AbdulAzeez0001/dronekit-pro/docs/README.md

# Documentation (CC-BY-SA 4.0)

The kit documentation, assembly guide, and the BOM cost analysis live here.

Keep the unverified price claim out of the user-facing docs until the
JLC/LCSC quote confirms it.
