AbdulAzeez0001/dronekit-pro/firmware/README.md

# Firmware

## esp32/  (MIT)
WiFi access point, control panel server (192.168.4.1), WebSocket JSON API,
UART bridge to the STM32, OTA. Develop and test most of this on a spare
ESP32 dev board before the real PCB exists.

## betaflight/  (GPLv3)
Custom Betaflight target for the STM32F405 pinmap, plus the CLI dump from
the kit documentation. This is a Betaflight derivative and is GPLv3.
Test the target logic with Betaflight SITL before flashing hardware.
