AbdulAzeez0001/dronekit-pro/hardware/kicad/baro_flash.kicad_sch

## KiCad design hardware/kicad/baro_flash.kicad_sch (2026-09-07, an earlier design)

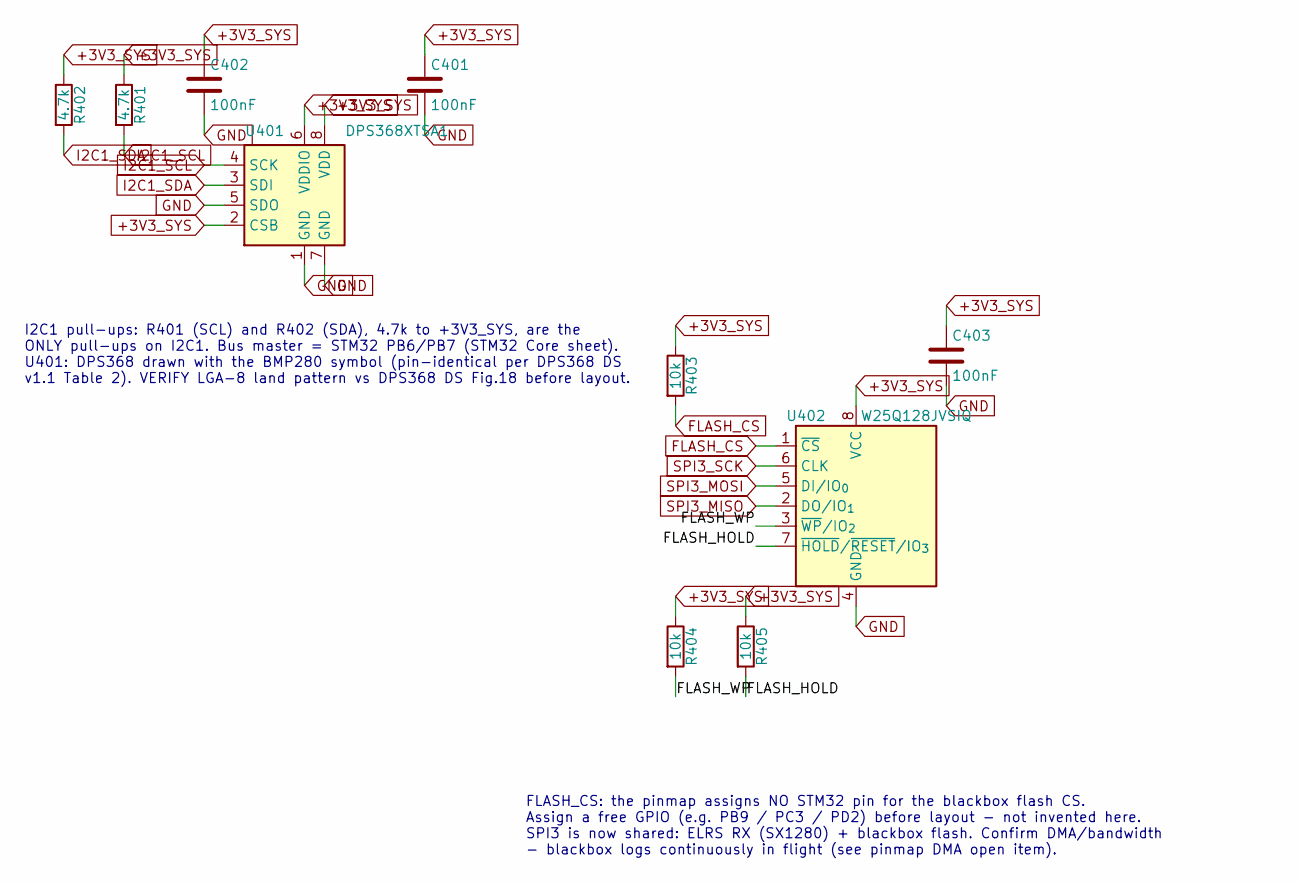
[picture p1: schematic baro_flash.kicad_sch]

Parts:
C401, C402, C403: 100nF; C_0603_1608Metric; MPN CC0603KRX7R9BB104; LCSC C14663
R401, R402: 4.7k; R_0603_1608Metric; MPN 0603WAF4701T5E; LCSC C23162
R403, R404, R405: 10k; R_0603_1608Metric; MPN 0603WAF1002T5E; LCSC C25804
U401: DPS368XTSA1; Bosch_LGA-8_2x2.5mm_P0.65mm_ClockwisePinNumbering; MPN DPS368XTSA1; LCSC C3232508
U402: W25Q128JVSIQ; SOIC-8_5.3x5.3mm_P1.27mm; MPN W25Q128JVSIQ; LCSC C97521

Connections:
+3V3_SYS: C401.1, C402.1, C403.1, R401.1, R402.1, R403.1, R404.1, R405.1, U401.2 (CSB), U401.6 (VDDIO), U401.8 (VDD), U402.8 (VCC)
FLASH_CS: R403.2, U402.1 (~CS)
FLASH_HOLD: R405.2, U402.7 (~HOLD/~RESET/IO_{3})
FLASH_WP: R404.2, U402.3 (~WP/IO_{2})
GND: C401.2, C402.2, C403.2, U401.1 (GND), U401.5 (SDO), U401.7 (GND), U402.4 (GND)
I2C1_SCL: R401.2, U401.4 (SCK)
I2C1_SDA: R402.2, U401.3 (SDI)
SPI3_MISO: U402.2 (DO/IO_{1})
SPI3_MOSI: U402.5 (DI/IO_{0})
SPI3_SCK: U402.6 (CLK)

Notes on the sheet:
I2C1 pull-ups: R401 (SCL) and R402 (SDA), 4.7k to +3V3_SYS, are the ONLY pull-ups on I2C1. Bus master = STM32 PB6/PB7 (STM32 Core sheet). U401: DPS368 drawn with the BMP280 symbol (pin-identical per DPS368 DS v1.1 Table 2). VERIFY LGA-8 land pattern vs DPS368 DS Fig.18 before layout.
FLASH_CS: the pinmap assigns NO STM32 pin for the blackbox flash CS. Assign a free GPIO (e.g. PB9 / PC3 / PD2) before layout - not invented here. SPI3 is now shared: ELRS RX (SX1280) + blackbox flash. Confirm DMA/bandwidth - blackbox logs continuously in flight (see pinmap DMA open item).
