AbdulAzeez0001/dronekit-pro/hardware/kicad/connectors.kicad_sch

## KiCad design hardware/kicad/connectors.kicad_sch (2026-09-07, an earlier design)

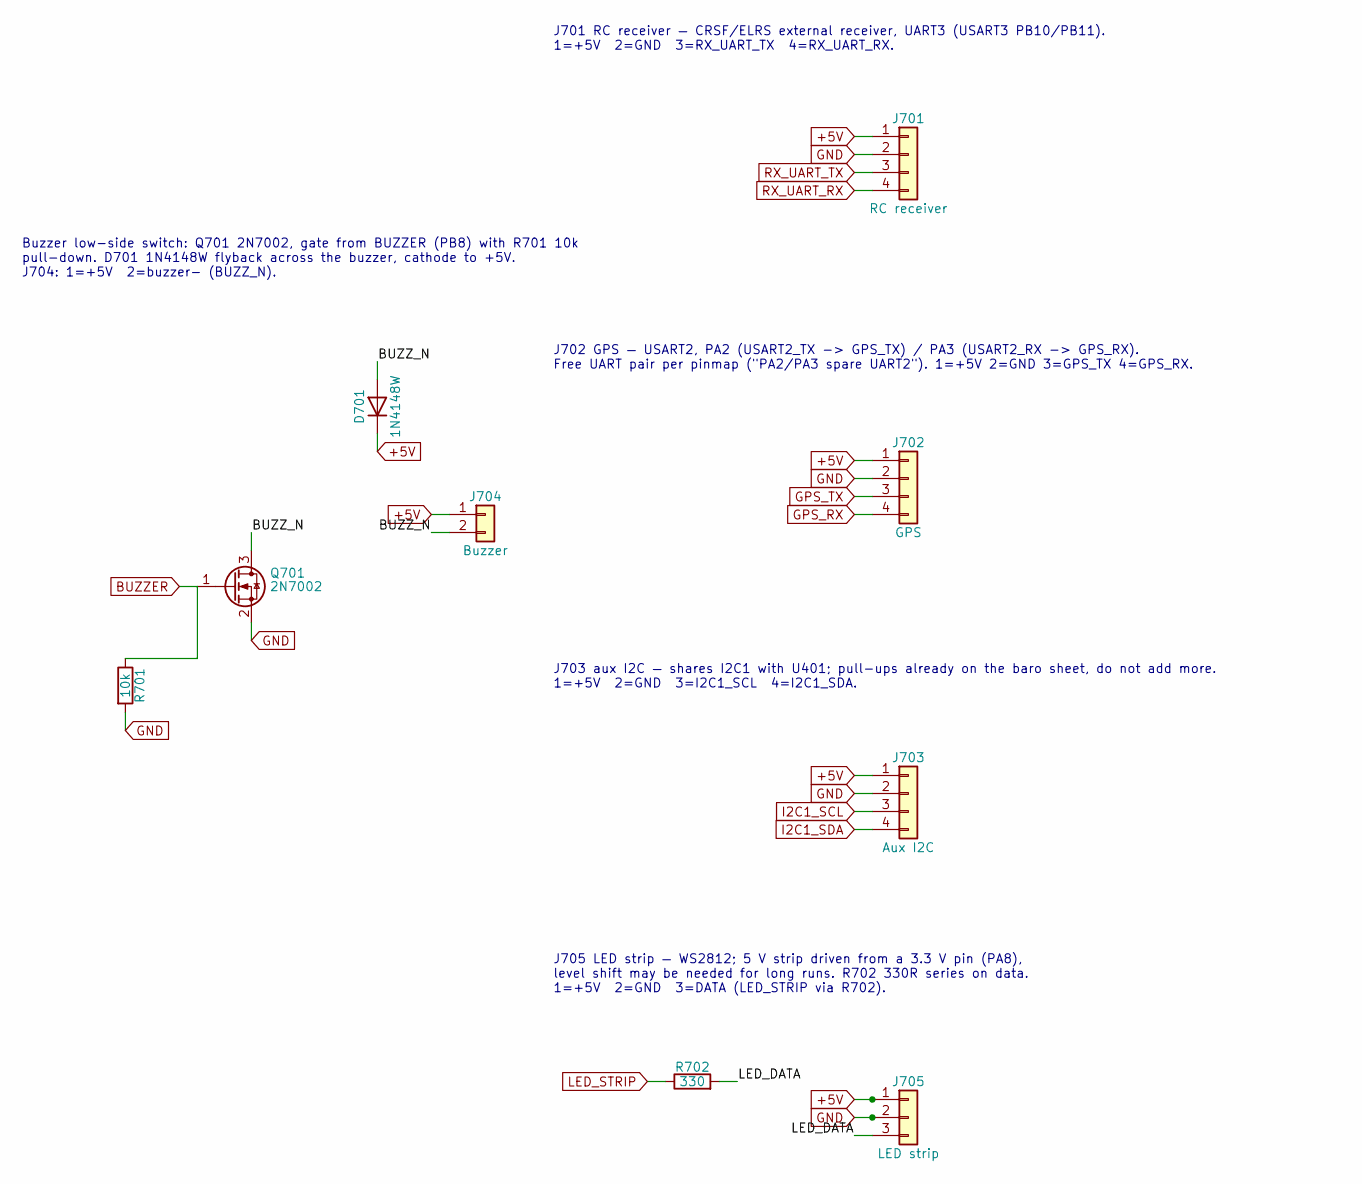
[picture p2: schematic connectors.kicad_sch]

Parts:
D701: 1N4148W; D_SOD-123; MPN 1N4148W; LCSC C81598
J701: RC receiver; JST_SH_SM04B-SRSS-TB_1x04-1MP_P1.00mm_Horizontal; MPN SM04B-SRSS-TB(LF)(SN); LCSC C160404
J702: GPS; JST_SH_SM04B-SRSS-TB_1x04-1MP_P1.00mm_Horizontal; MPN SM04B-SRSS-TB(LF)(SN); LCSC C160404
J703: Aux I2C; JST_SH_SM04B-SRSS-TB_1x04-1MP_P1.00mm_Horizontal; MPN SM04B-SRSS-TB(LF)(SN); LCSC C160404
J704: Buzzer; JST_SH_SM02B-SRSS-TB_1x02-1MP_P1.00mm_Horizontal; MPN SM02B-SRSS-TB(LF)(SN); LCSC C160402
J705: LED strip; JST_SH_SM03B-SRSS-TB_1x03-1MP_P1.00mm_Horizontal; MPN SM03B-SRSS-TB(LF)(SN); LCSC C160403
Q701: 2N7002; SOT-23; MPN 2N7002; LCSC C8545
R701: 10k; R_0603_1608Metric; MPN 0603WAF1002T5E; LCSC C25804
R702: 330; R_0603_1608Metric; MPN 0603WAF3300T5E; LCSC C23138

Connections:
+5V: D701.1 (K), J701.1, J702.1, J703.1, J704.1, J705.1
BUZZER: Q701.1 (G), R701.1
BUZZ_N: D701.2 (A), J704.2, Q701.3 (D)
GND: J701.2, J702.2, J703.2, J705.2, Q701.2 (S), R701.2
GPS_RX: J702.4
GPS_TX: J702.3
I2C1_SCL: J703.3
I2C1_SDA: J703.4
LED_DATA: J705.3, R702.2
LED_STRIP: R702.1
RX_UART_RX: J701.4
RX_UART_TX: J701.3

Notes on the sheet:
J701 RC receiver — CRSF/ELRS external receiver, UART3 (USART3 PB10/PB11). 1=+5V 2=GND 3=RX_UART_TX 4=RX_UART_RX.
J702 GPS — USART2, PA2 (USART2_TX -> GPS_TX) / PA3 (USART2_RX -> GPS_RX). Free UART pair per pinmap ("PA2/PA3 spare UART2"). 1=+5V 2=GND 3=GPS_TX 4=GPS_RX.
J703 aux I2C — shares I2C1 with U401; pull-ups already on the baro sheet, do not add more. 1=+5V 2=GND 3=I2C1_SCL 4=I2C1_SDA.
J705 LED strip — WS2812; 5 V strip driven from a 3.3 V pin (PA8), level shift may be needed for long runs. R702 330R series on data. 1=+5V 2=GND 3=DATA (LED_STRIP via R702).
Buzzer low-side switch: Q701 2N7002, gate from BUZZER (PB8) with R701 10k pull-down. D701 1N4148W flyback across the buzzer, cathode to +5V. J704: 1=+5V 2=buzzer- (BUZZ_N).
