AbdulAzeez0001/dronekit-pro/hardware/kicad/dronekit-pro.kicad_sch

## KiCad design hardware/kicad/dronekit-pro.kicad_sch (2026-09-07, an earlier design)

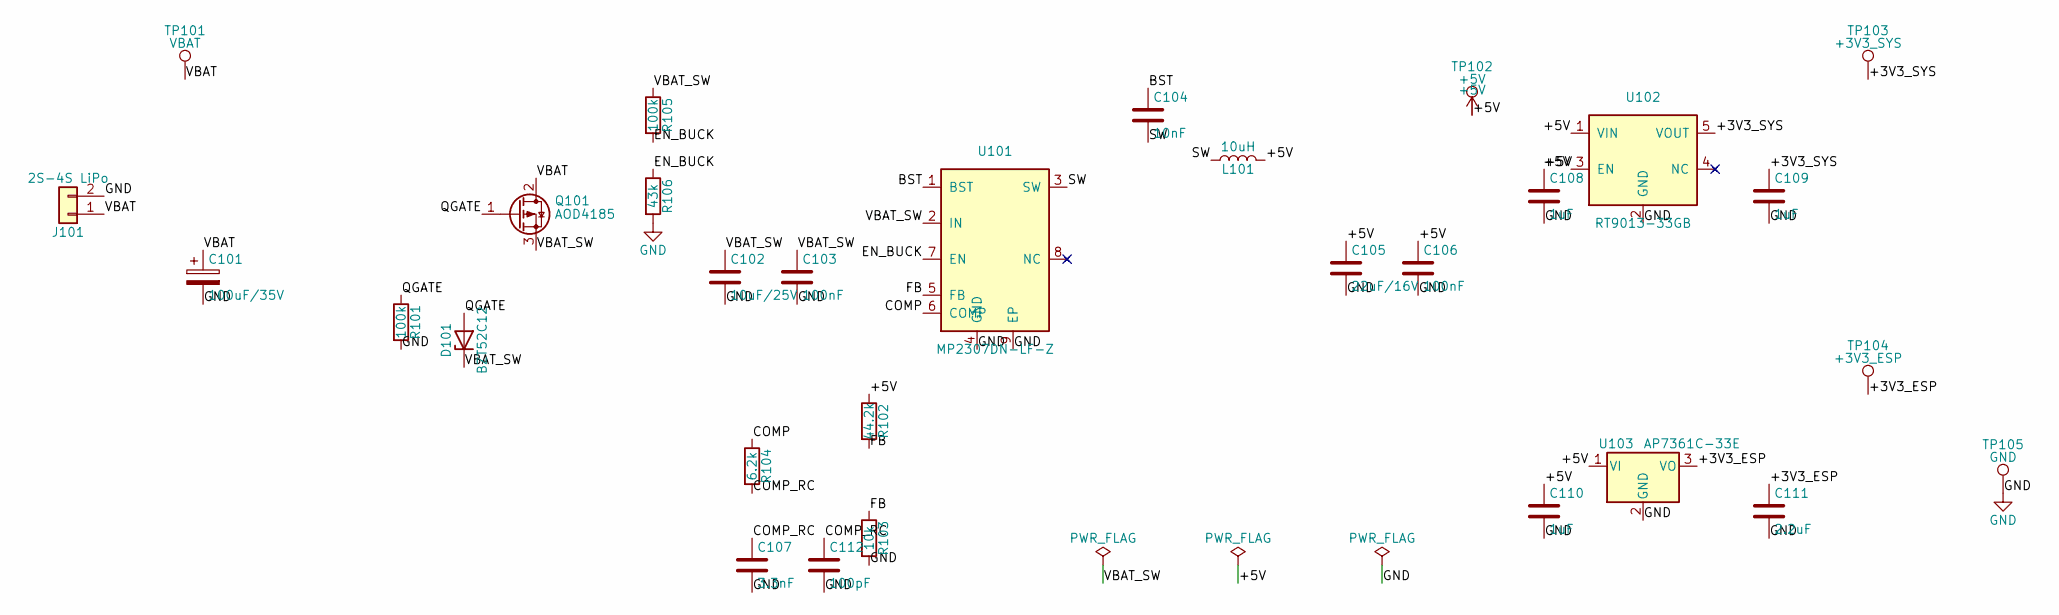
[picture p3: schematic dronekit-pro.kicad_sch]

Parts:
C101: 100uF/35V; CP_Elec_6.3x7.7
C102: 10uF/25V; C_1210_3225Metric
C103, C106: 100nF; C_0603_1608Metric
C104: 10nF; C_0603_1608Metric
C105: 22uF/16V; C_1206_3216Metric
C107: 3.3nF; C_0603_1608Metric
C108, C109, C110: 1uF; C_0603_1608Metric
C111: 2.2uF; C_0603_1608Metric
C112: 100pF; C_0603_1608Metric
D101: BZT52C12; D_SOD-123; LCSC C43491
J101: 2S-4S LiPo; PhoenixContact_MSTBA_2,5_2-G-5,08_1x02_P5.08mm_Horizontal; LCSC C474952
L101: 10uH; L_12x12mm_H8mm; Rating Isat 9A, Irms 5.4A, DCR 21mOhm; MPN SMDRI127-100MT; LCSC C9904
Q101: AOD4185; TO-252-2; LCSC C400894
R101, R105: 100k; R_0603_1608Metric
R102: 44.2k; R_0603_1608Metric
R103: 10k; R_0603_1608Metric
R104: 6.2k; R_0603_1608Metric
R106: 43k; R_0603_1608Metric
TP101: VBAT; TestPoint_Pad_D1.5mm
TP102: +5V; TestPoint_Pad_D1.5mm
TP103: +3V3_SYS; TestPoint_Pad_D1.5mm
TP104: +3V3_ESP; TestPoint_Pad_D1.5mm
TP105: GND; TestPoint_Pad_D1.5mm
U101: MP2307DN-LF-Z; SOIC-8-1EP_3.9x4.9mm_P1.27mm_EP2.29x3mm; LCSC C18921
U102: RT9013-33GB; SOT-23-5; LCSC C47773
U103: AP7361C-33E; SOT-223-3_TabPin2; LCSC C500795

Connections:
+3V3_ESP: C111.1, TP104.1, U103.3 (VO)
+3V3_SYS: C109.1, TP103.1, U102.5 (VOUT)
+5V: C105.1, C106.1, C108.1, C110.1, L101.2, R102.1, TP102.1, U102.1 (VIN), U102.3 (EN), U103.1 (VI)
BST: C104.1, U101.1 (BST)
COMP: R104.1, U101.6 (COMP)
COMP_RC: C107.1, C112.1, R104.2
EN_BUCK: R105.2, R106.1, U101.7 (EN)
FB: R102.2, R103.1, U101.5 (FB)
GND: C101.2, C102.2, C103.2, C105.2, C106.2, C107.2, C108.2, C109.2, C110.2, C111.2, C112.2, J101.2, R101.2, R103.2, R106.2, TP105.1, U101.4 (GND), U101.9 (EP), U102.2 (GND), U103.2 (GND)
QGATE: D101.2 (A), Q101.1 (G), R101.1
SW: C104.2, L101.1, U101.3 (SW)
VBAT: C101.1, J101.1, Q101.2 (D), TP101.1
VBAT_SW: C102.1, C103.1, D101.1 (K), Q101.3 (S), R105.1, U101.2 (IN)
