AbdulAzeez0001/dronekit-pro/hardware/kicad/esp32.kicad_sch

## KiCad design hardware/kicad/esp32.kicad_sch (2026-09-06)

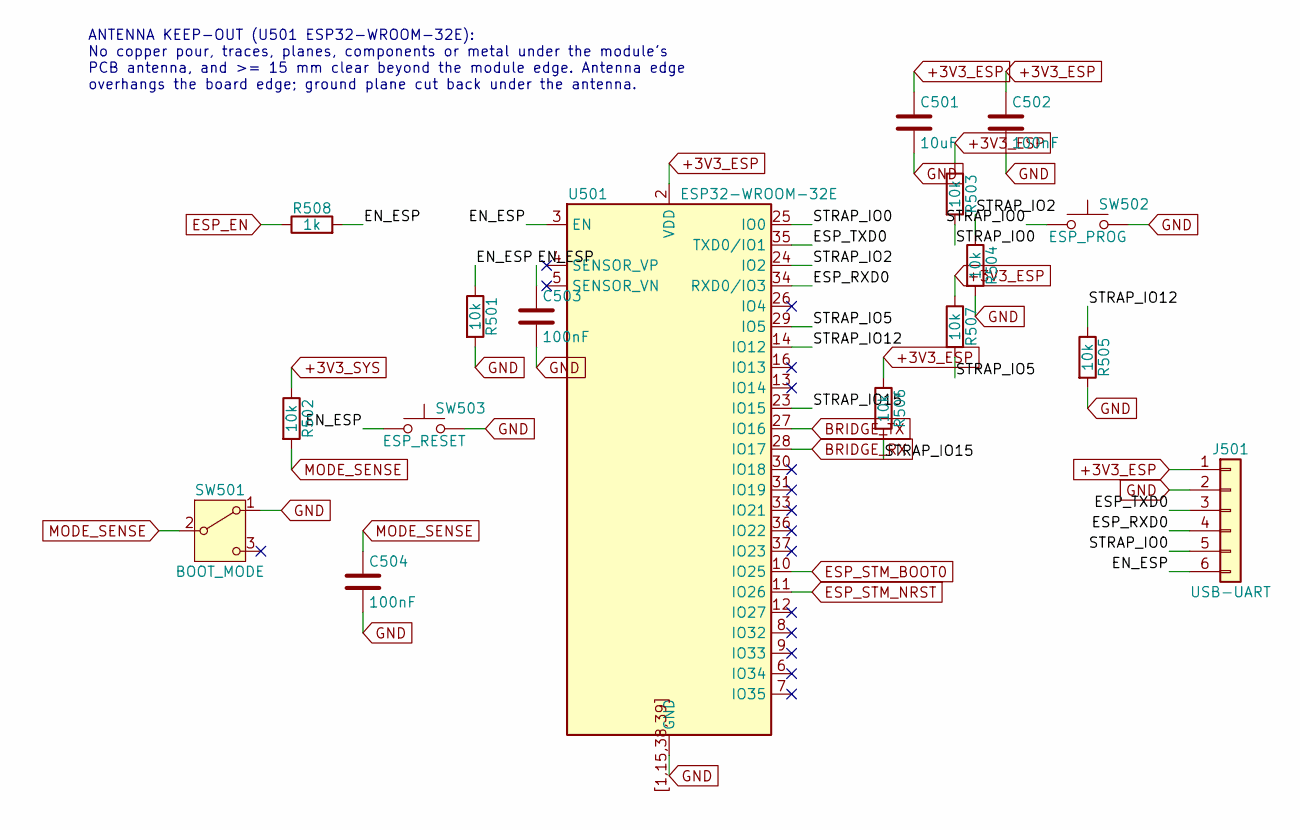
[picture p4: schematic esp32.kicad_sch]

Parts:
C501: 10uF; C_0805_2012Metric; MPN CL21A106KOQNNNE; LCSC C1713
C502, C503, C504: 100nF; C_0402_1005Metric; MPN CL05B104KO5NNNC; LCSC C1525
J501: USB-UART; PinHeader_1x06_P2.54mm_Vertical; MPN 2.54-1*40P Straight Pin (cut to 6); LCSC C2337
R501, R502, R503, R504, R505, R506, R507: 10k; R_0402_1005Metric; MPN 0402WGF1002TCE; LCSC C25744
R508: 1k; R_0402_1005Metric; MPN 0402WGF1001TCE; LCSC C11702
SW501: BOOT_MODE; SW_SPDT_Shouhan_MSK12C02; MPN MSK12C02; LCSC C431540
SW502: ESP_PROG; SW_SPST_TS-1088-xR020; MPN TS-1088-AR02016; LCSC C720477
SW503: ESP_RESET; SW_SPST_TS-1088-xR020; MPN TS-1088-AR02016; LCSC C720477
U501: ESP32-WROOM-32E; MPN ESP32-WROOM-32E-N4; LCSC C701341

Connections:
+3V3_ESP: C501.1, C502.1, J501.1, R503.1, R506.1, R507.1, U501.2 (VDD)
+3V3_SYS: R502.1
BRIDGE_RX: U501.28 (IO17)
BRIDGE_TX: U501.27 (IO16)
EN_ESP: C503.1, J501.6, R501.1, R508.2, SW503.1, U501.3 (EN)
ESP_EN: R508.1
ESP_RXD0: J501.4, U501.34 (RXD0/IO3)
ESP_STM_BOOT0: U501.10 (IO25)
ESP_STM_NRST: U501.11 (IO26)
ESP_TXD0: J501.3, U501.35 (TXD0/IO1)
GND: C501.2, C502.2, C503.2, C504.2, J501.2, R501.2, R504.2, R505.2, SW501.1 (A), SW502.2, SW503.2, U501.[1,15,38,39] (GND)
MODE_SENSE: C504.1, R502.2, SW501.2 (B)
STRAP_IO0: J501.5, R503.2, SW502.1, U501.25 (IO0)
STRAP_IO2: R504.1, U501.24 (IO2)
STRAP_IO5: R507.2, U501.29 (IO5)
STRAP_IO12: R505.1, U501.14 (IO12)
STRAP_IO15: R506.2, U501.23 (IO15)

Notes on the sheet:
ANTENNA KEEP-OUT (U501 ESP32-WROOM-32E): No copper pour, traces, planes, components or metal under the module's PCB antenna, and >= 15 mm clear beyond the module edge. Antenna edge overhangs the board edge; ground plane cut back under the antenna.
