AbdulAzeez0001/dronekit-pro/hardware/kicad/imu.kicad_sch

## KiCad design hardware/kicad/imu.kicad_sch (2026-09-07, an earlier design)

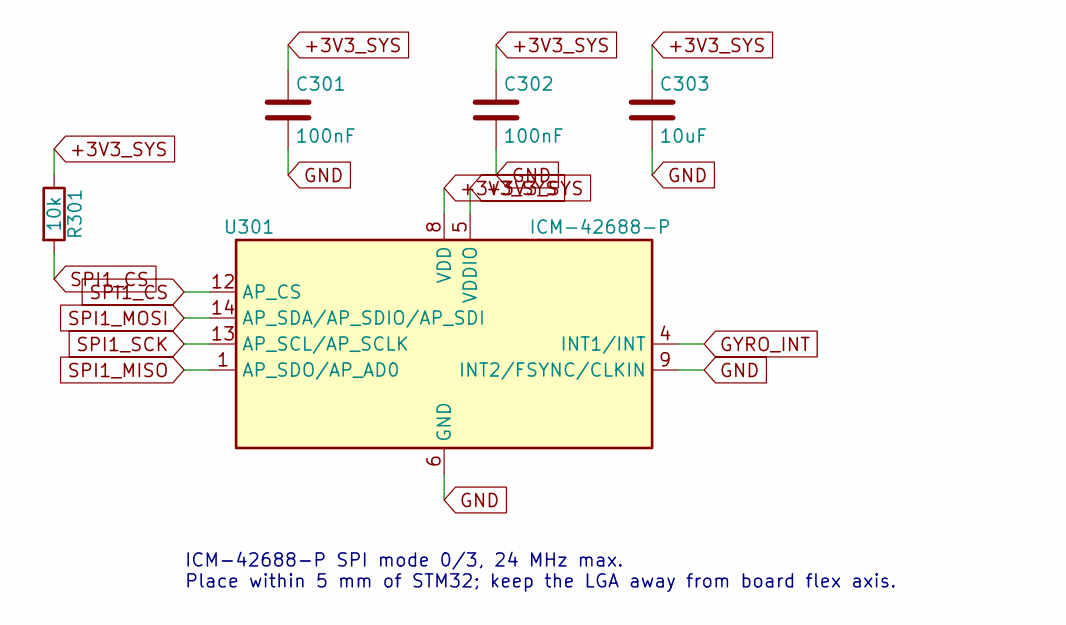
[picture p5: schematic imu.kicad_sch]

Parts:
C301, C302: 100nF; C_0603_1608Metric; MPN CC0603KRX7R9BB104; LCSC C14663
C303: 10uF; C_0603_1608Metric; MPN CL10A106MA8NRNC; LCSC C96446
R301: 10k; R_0603_1608Metric; MPN 0603WAF1002T5E; LCSC C25804
U301: ICM-42688-P; Bosch_LGA-14_3x2.5mm_P0.5mm; MPN ICM-42688-P; LCSC C1850418

Connections:
+3V3_SYS: C301.1, C302.1, C303.1, R301.1, U301.5 (VDDIO), U301.8 (VDD)
GND: C301.2, C302.2, C303.2, U301.6 (GND), U301.7 (GND), U301.9 (INT2/FSYNC/CLKIN)
GYRO_INT: U301.4 (INT1/INT)
SPI1_CS: R301.2, U301.12 (AP_CS)
SPI1_MISO: U301.1 (AP_SDO/AP_AD0)
SPI1_MOSI: U301.14 (AP_SDA/AP_SDIO/AP_SDI)
SPI1_SCK: U301.13 (AP_SCL/AP_SCLK)

Notes on the sheet:
ICM-42688-P SPI mode 0/3, 24 MHz max. Place within 5 mm of STM32; keep the LGA away from board flex axis.
