AbdulAzeez0001/dronekit-pro/hardware/kicad/motors.kicad_sch

## KiCad design hardware/kicad/motors.kicad_sch (2026-09-07)

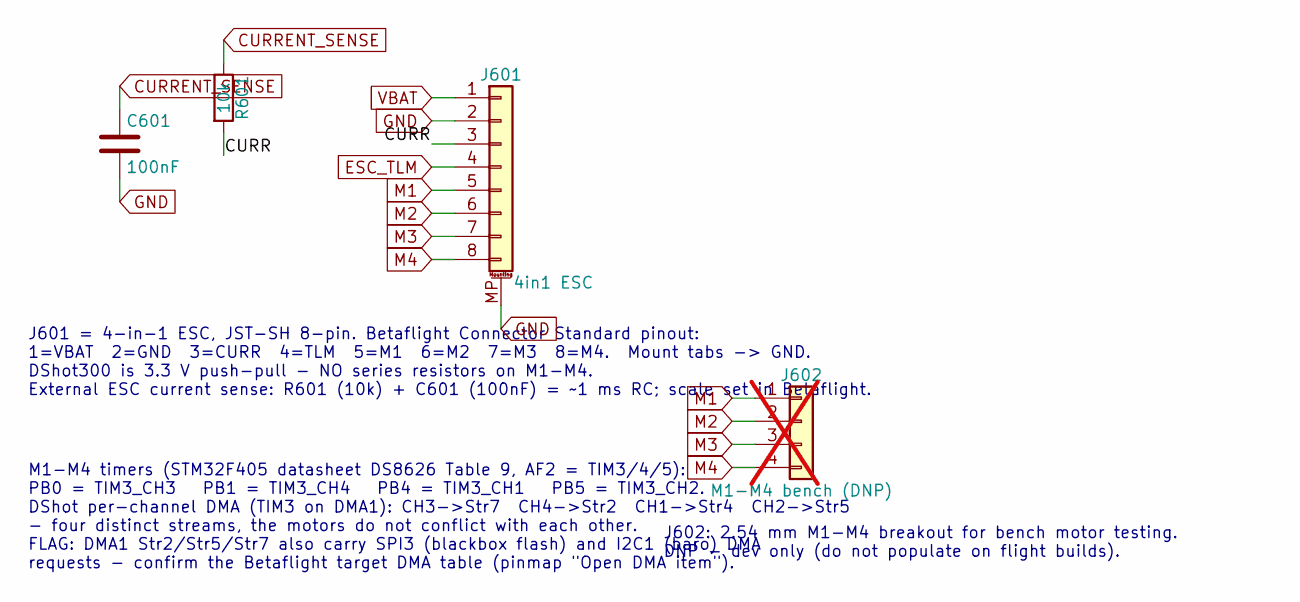
[picture p6: schematic motors.kicad_sch]

Parts:
C601: 100nF; C_0603_1608Metric; MPN CC0603KRX7R9BB104; LCSC C14663
J601: 4in1 ESC; JST_SH_SM08B-SRSS-TB_1x08-1MP_P1.00mm_Horizontal; MPN SM08B-SRSS-TB(LF)(SN); LCSC C160407
J602: M1-M4 bench (DNP); PinHeader_1x04_P2.54mm_Vertical; MPN 2.54-1*40P Straight Pin (cut to 4); LCSC C2337; not fitted
R601: 10k; R_0603_1608Metric; MPN 0603WAF1002T5E; LCSC C25804

Connections:
CURR: J601.3, R601.2
CURRENT_SENSE: C601.1, R601.1
ESC_TLM: J601.4
GND: C601.2, J601.2, J601.MP (MountPin)
M1: J601.5, J602.1
M2: J601.6, J602.2
M3: J601.7, J602.3
M4: J601.8, J602.4
VBAT: J601.1

Notes on the sheet:
J601 = 4-in-1 ESC, JST-SH 8-pin. Betaflight Connector Standard pinout: 1=VBAT 2=GND 3=CURR 4=TLM 5=M1 6=M2 7=M3 8=M4. Mount tabs -> GND. DShot300 is 3.3 V push-pull - NO series resistors on M1-M4. External ESC current sense: R601 (10k) + C601 (100nF) = ~1 ms RC; scale set in Betaflight.
M1-M4 timers (STM32F405 datasheet DS8626 Table 9, AF2 = TIM3/4/5): PB0 = TIM3_CH3 PB1 = TIM3_CH4 PB4 = TIM3_CH1 PB5 = TIM3_CH2. DShot per-channel DMA (TIM3 on DMA1): CH3->Str7 CH4->Str2 CH1->Str4 CH2->Str5 - four distinct streams, the motors do not conflict with each other. FLAG: DMA1 Str2/Str5/Str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
J602: 2.54 mm M1-M4 breakout for bench motor testing. DNP - dev only (do not populate on flight builds).
