AbdulAzeez0001/dronekit-pro/hardware/kicad/stm32_core.kicad_sch

## KiCad design hardware/kicad/stm32_core.kicad_sch (2026-09-07, an earlier design)

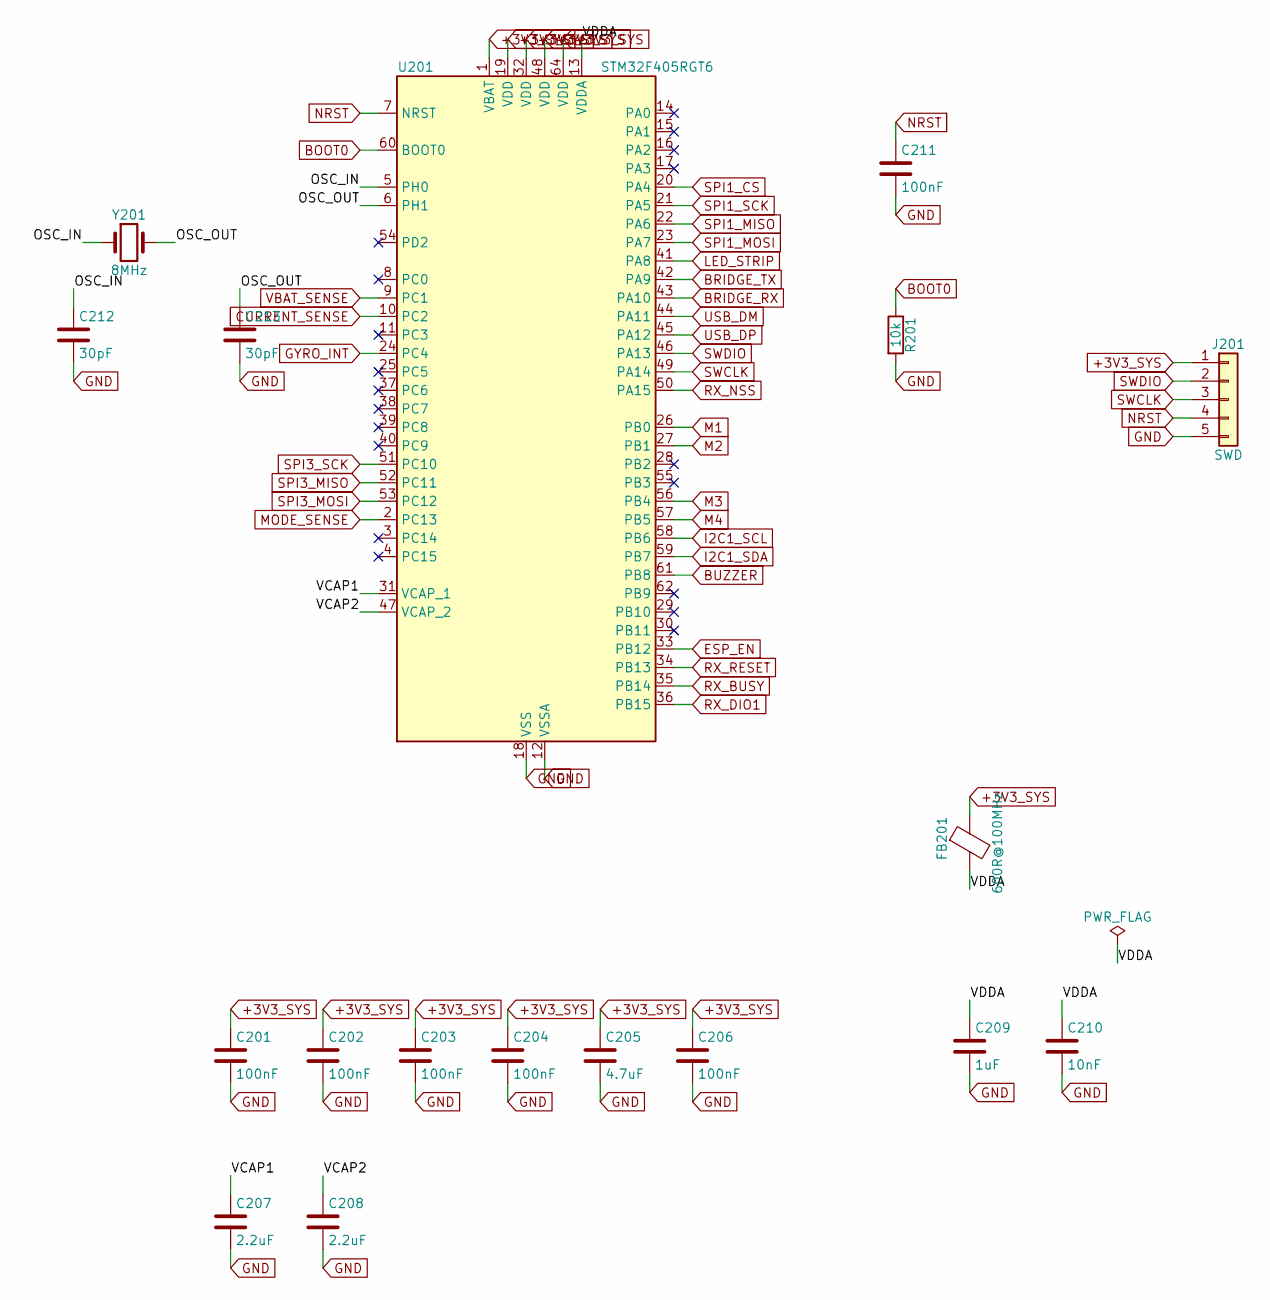
[picture p7: schematic stm32_core.kicad_sch]

Parts:
C201, C202, C203, C204, C206, C211: 100nF; C_0603_1608Metric; MPN CC0603KRX7R9BB104; LCSC C14663
C205: 4.7uF; C_0805_2012Metric; MPN CL21A475KAQNNNE; LCSC C1779
C207, C208: 2.2uF; C_0603_1608Metric; MPN CL10A225KO8NNNC; LCSC C23630
C209: 1uF; C_0603_1608Metric; MPN CL10A105KO8NNNC; LCSC C1592
C210: 10nF; C_0603_1608Metric; MPN CL10B103KB8NNNC; LCSC C1589
C212, C213: 30pF; C_0603_1608Metric; MPN 0603CG300J500NT; LCSC C1658
FB201: 600R@100MHz; L_0805_2012Metric; Rating 600R@100MHz, 300mOhm, 500mA, 0805; MPN GZ2012D601TF; LCSC C1017
J201: SWD; PinHeader_1x05_P2.54mm_Vertical; MPN 2.54-1*40P Straight Pin (cut to 5); LCSC C2337
R201: 10k; R_0603_1608Metric; MPN 0603WAF1002T5E; LCSC C25804
U201: STM32F405RGT6; LQFP-64_10x10mm_P0.5mm; MPN STM32F405RGT6; LCSC C15742
Y201: 8MHz; Crystal_SMD_5032-2Pin_5.0x3.2mm; Tolerance 10ppm; MPN X50328MSB2GI; LCSC C115962

Connections:
+3V3_SYS: C201.1, C202.1, C203.1, C204.1, C205.1, C206.1, FB201.1, J201.1, U201.1 (VBAT), U201.19 (VDD), U201.32 (VDD), U201.48 (VDD), U201.64 (VDD)
BOOT0: R201.1, U201.60 (BOOT0)
BRIDGE_RX: U201.43 (PA10)
BRIDGE_TX: U201.42 (PA9)
BUZZER: U201.61 (PB8)
CURRENT_SENSE: U201.10 (PC2)
ESP_EN: U201.33 (PB12)
GND: C201.2, C202.2, C203.2, C204.2, C205.2, C206.2, C207.2, C208.2, C209.2, C210.2, C211.2, C212.2, C213.2, J201.5, R201.2, U201.12 (VSSA), U201.18 (VSS), U201.63 (VSS)
GYRO_INT: U201.24 (PC4)
I2C1_SCL: U201.58 (PB6)
I2C1_SDA: U201.59 (PB7)
LED_STRIP: U201.41 (PA8)
M1: U201.26 (PB0)
M2: U201.27 (PB1)
M3: U201.56 (PB4)
M4: U201.57 (PB5)
MODE_SENSE: U201.2 (PC13)
NRST: C211.1, J201.4, U201.7 (NRST)
OSC_IN: C212.1, U201.5 (PH0), Y201.1
OSC_OUT: C213.1, U201.6 (PH1), Y201.2
RX_BUSY: U201.35 (PB14)
RX_DIO1: U201.36 (PB15)
RX_NSS: U201.50 (PA15)
RX_RESET: U201.34 (PB13)
SPI1_CS: U201.20 (PA4)
SPI1_MISO: U201.22 (PA6)
SPI1_MOSI: U201.23 (PA7)
SPI1_SCK: U201.21 (PA5)
SPI3_MISO: U201.52 (PC11)
SPI3_MOSI: U201.53 (PC12)
SPI3_SCK: U201.51 (PC10)
SWCLK: J201.3, U201.49 (PA14)
SWDIO: J201.2, U201.46 (PA13)
USB_DM: U201.44 (PA11)
USB_DP: U201.45 (PA12)
VBAT_SENSE: U201.9 (PC1)
VCAP1: C207.1, U201.31 (VCAP_1)
VCAP2: C208.1, U201.47 (VCAP_2)
VDDA: C209.1, C210.1, FB201.2, U201.13 (VDDA)
