AbdulAzeez0001/dronekit-pro/hardware/kicad/usb_power.kicad_sch

## KiCad design hardware/kicad/usb_power.kicad_sch (2026-09-07, an earlier design)

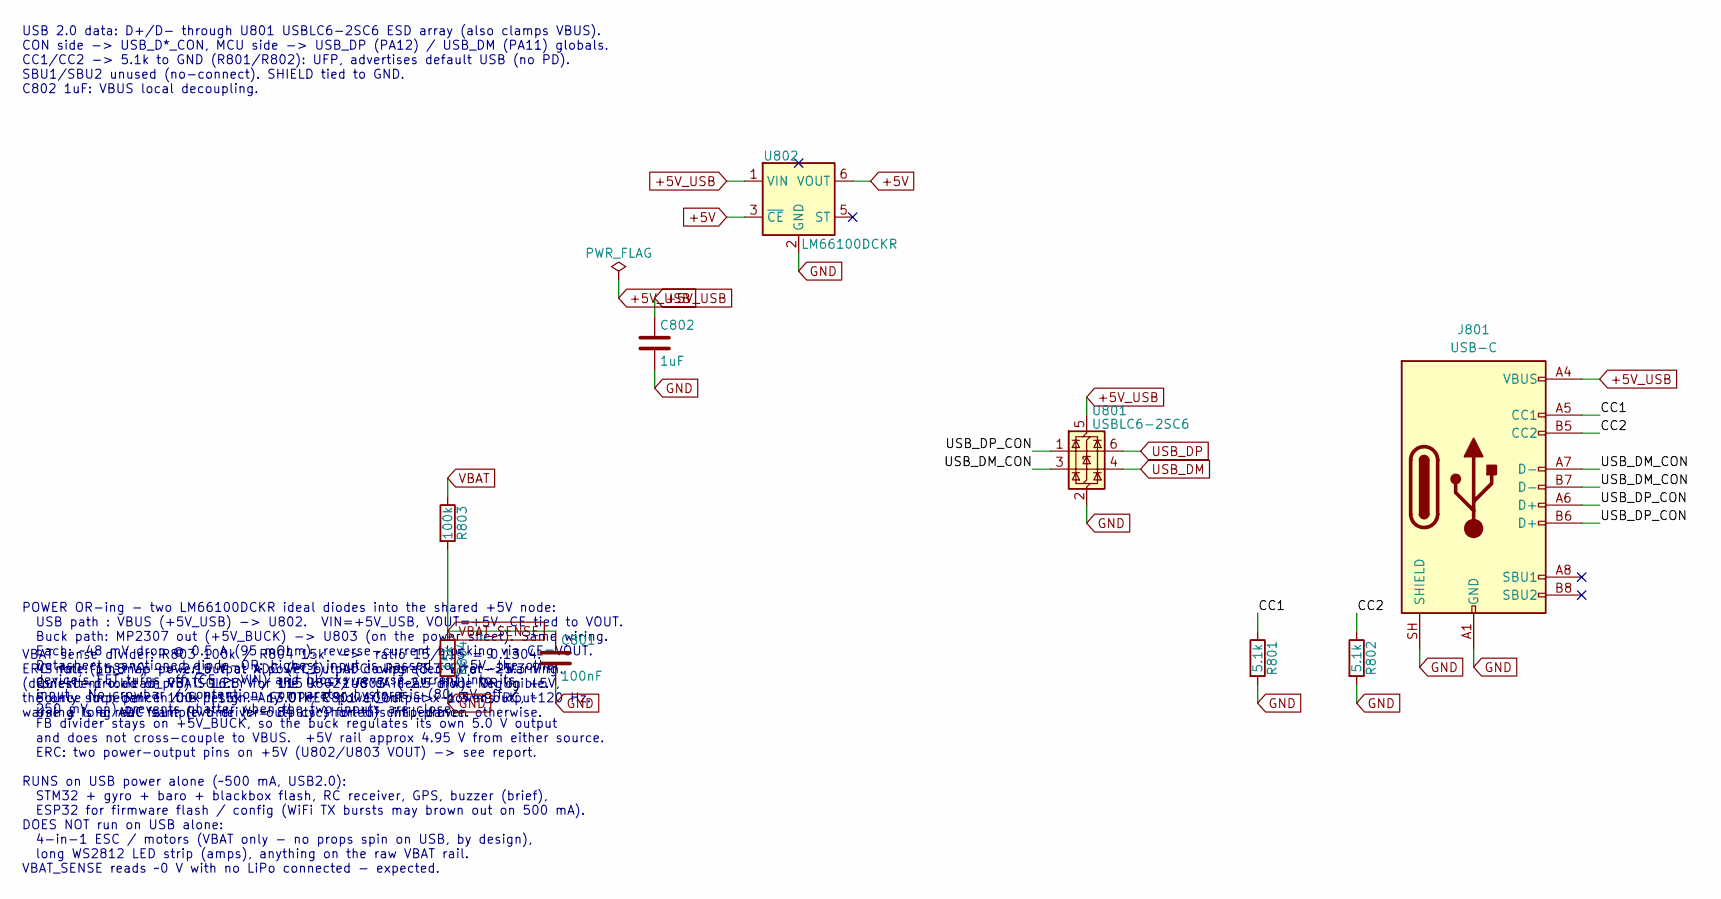
[picture p8: schematic usb_power.kicad_sch]

Parts:
C801: 100nF; C_0603_1608Metric; MPN CC0603KRX7R9BB104; LCSC C14663
C802: 1uF; C_0603_1608Metric; MPN CL10A105KB8NNNC; LCSC C15849
J801: USB-C; USB_C_Receptacle_HRO_TYPE-C-31-M-12; MPN TYPE-C-31-M-12; LCSC C165948
R801, R802: 5.1k; R_0603_1608Metric; MPN 0603WAF5101T5E; LCSC C23186
R803: 100k; R_0603_1608Metric; MPN 0603WAF1003T5E; LCSC C25803
R804: 15k; R_0603_1608Metric; MPN 0603WAF1502T5E; LCSC C22809
U801: USBLC6-2SC6; SOT-23-6; MPN USBLC6-2SC6; LCSC C7519
U802: LM66100DCKR; SOT-363_SC-70-6; MPN LM66100DCKR; LCSC C2869734

Connections:
+5V: U802.3 (~CE), U802.6 (VOUT)
+5V_USB: C802.1, J801.A4 (VBUS), J801.A9 (VBUS), J801.B4 (VBUS), J801.B9 (VBUS), U801.5 (VBUS), U802.1 (VIN)
CC1: J801.A5 (CC1), R801.1
CC2: J801.B5 (CC2), R802.1
GND: C801.2, C802.2, J801.A1 (GND), J801.A12 (GND), J801.B1 (GND), J801.B12 (GND), J801.SH (SHIELD), R801.2, R802.2, R804.2, U801.2 (GND), U802.2 (GND)
USB_DM: U801.4 (I/O2)
USB_DM_CON: J801.A7 (D-), J801.B7 (D-), U801.3 (I/O2)
USB_DP: U801.6 (I/O1)
USB_DP_CON: J801.A6 (D+), J801.B6 (D+), U801.1 (I/O1)
VBAT: R803.1
VBAT_SENSE: C801.1, R803.2, R804.1

Notes on the sheet:
VBAT sense divider: R803 100k / R804 15k -> ratio 15/115 = 0.1304. 4S full (16.8 V) -> 2.19 V at ADC (PC1). ADC clips (3.3 V) at ~25.3 V in. Quiescent load on VBAT: 16.8 V / 115 k = 146 uA (~2.5 mW). Negligible. Source impedance 100k||15k = 13.0 k; C801 100nF -> ~1.3 ms RC, ~120 Hz. Use a long ADC 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
USB 2.0 data: D+/D- through U801 USBLC6-2SC6 ESD array (also clamps VBUS). CON side -> USB_D*_CON, MCU side -> USB_DP (PA12) / USB_DM (PA11) globals. CC1/CC2 -> 5.1k to GND (R801/R802): UFP, advertises default USB (no PD). SBU1/SBU2 unused (no-connect). SHIELD tied to GND. C802 1uF: VBUS local deco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
POWER OR-ing - two LM66100DCKR ideal diodes into the shared +5V node: USB path : VBUS (+5V_USB) -> U802. VIN=+5V_USB, VOUT=+5V, CE tied to VOUT. Buck path: MP2307 out (+5V_BUCK) -> U803 (on the power sheet). Same wiring. Each: ~48 mV drop @ 0.5 A (95 mOhm), reverse-current blocking via CE=VOUT. Dat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
ERC note: pin_map power_output x power_output downgraded Error->Warning (dronekit-pro.kicad_pro) SOLELY for the U802/U803 ideal-diode OR on +5V, the only such pair in the design. Any OTHER power_output x power_output warning is a real fault (two driver outputs shorted) until proven otherwise.
