AbdulAzeez0001/dronekit-pro/(commit log)

2026-06-22 Add verified dual-boot control circuit design
2026-06-24 Add power design; update dual-boot for split rails
2026-07-10 Add STM32F405 pin map with dual-boot reconciliation
2026-07-12 Add Block 1 power tree
2026-07-24 Add structural-PCB kit assembly model
2026-09-06 KiCad: Block 1 power tree via Konnect, ERC clean
    [dronekit-pro.kicad_pcb, dronekit-pro.kicad_sch]
2026-09-06 Input spec 3S–4S LiPo; J101 relabelled, UVLO note near U101
    [dronekit-pro.kicad_sch]
2026-09-06 Block 2A: STM32F405 core sheet; Block 1 rails promoted to global
    [dronekit-pro.kicad_sch, stm32_core.kicad_sch]
2026-09-06 Block 5: ESP32 sheet, mode switch, UART bridge, flash lines; PB12 series R; Block 1 GND to power symbols
    Claude-Session: https://claude.ai/code/session_01JDQYoFvbjRHNSgGtfc2pWo
    [dronekit-pro.kicad_sch, esp32.kicad_sch, stm32_core.kicad_sch]
2026-09-06 Block 3: ICM-42688-P IMU on SPI1
    Also gitignore editor .history dir.
    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
    [dronekit-pro.kicad_sch, imu.kicad_sch]
2026-09-06 Block 3: footprint verification note; ERC severities unchanged
    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
    [imu.kicad_sch]
2026-09-06 Block 4: DPS368 baro + W25Q128 flash; drop onboard SPI-ELRS, flash on SPI3/PA15, RX on UART3
    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
    [baro_flash.kicad_sch, dronekit-pro.kicad_sch]
2026-09-06 Apply SPI-ELRS removal: FLASH_CS=PA15, RX_UART on PB10/PB11, PB13-15 spare
    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
    [baro_flash.kicad_sch, stm32_core.kicad_sch]
2026-09-07 Block 6: motors sheet, 4in1 ESC connector, current-sense RC, J602 DNP; promote Block 1 VBAT labels to global
    Claude-Session: https://claude.ai/code/session_0171uwNh8K8uwZuWio9f35u1
    [dronekit-pro.kicad_sch, motors.kicad_sch]
2026-09-07 Block 7: expansion connectors (RC, GPS, aux I2C, buzzer, LED)
    - J701 CRSF on USART3, J702 GPS on USART2 (PA2/PA3)
    - ESC_TLM assigned to UART5_RX (PD2), preserving USART2/4/6 as full pairs
    - Buzzer low-side 2N7002 with flyback clamp; LED strip via 330R series
    - Removes no-connect flags on PA2/PA3/PD2 in stm32_core
    - LED_DATA drives WS2812 at 3V3 (VIH marginal) - see sheet note
    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
    [connectors.kicad_sch, dronekit-pro.kicad_sch, stm32_core.kicad_sch]
2026-09-07 Block 8: USB-C, dual ideal-diode OR, VBAT sense
    - J801 USB-C 16P, USBLC6-2SC6 ESD array, 5.1k CC pull-downs (UFP, no PD)
    - U802/U803 LM66100 ideal diodes OR VBUS and +5V_BUCK onto +5V (~48 mV drop)
    - Buck output split to +5V_BUCK; FB divider moved to its own output, removing
    the cross-coupling between buck regulation and the USB source
    - Fixes MP2307 back-feed via high-side body diode when running on USB alone
    - VBAT sense 100k/15k -> PC1, 146 uA quiescent, needs >=84-cycle ADC sample time
    - ERC power_output x power_output downgraded to Warning for the sanctioned
    U802/U803 OR node only; see design-rule note
    Schematic complete: blocks 1-8, ERC 0 errors / 3 known warnings.
    Co-Authored-By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
    [dronekit-pro.kicad_sch, usb_power.kicad_sch]
2026-09-07 Verify IMU footprint; fix Block 7 LED and buzzer parts
    - U301 ICM-42688-P footprint verified against DS-000347 Rev 1.2 (LGA-14
    2.5x3.0, 0.5 mm pitch, C-C 2.525/2.025) — Bosch LGA-14 is a correct mate
    - D702 S2M 2A silicon in series on J705 strip VDD: drops strip to ~4.3 V so
    WS2812 VIH is reachable from the 3V3 data line
    - Q701 2N7002 -> AO3400A for buzzer current headroom
    - J705 note records the real limit: ~1 A / ~16 LEDs, capped by the JST-SH
    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
    [connectors.kicad_sch, imu.kicad_sch]
2026-09-07 Design review fixes: EN divider, +5V OR sizing, +5V bulk
    - R106 43k -> 39k: MP2307 EN lockout 2.5V typ gives ~8.9 V turn-on and
    keeps EN < 6 V abs-max to 20 V input (was 6.0 V, zero margin)
    - U803 LM66100 -> LM74700 + Q803 AO3400A: 1.5 A ceiling was below the
    ~1.9 A worst-case +5V budget; now FET-limited ~5 A at ~53 mV
    - C113 22uF on the +5V OR node (was ~2 uF of LDO input caps only)
    - ERC power_output x power_output reverted to Error; +5V now has a
    single power-output pin
    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
    [dronekit-pro.kicad_sch, usb_power.kicad_sch]
2026-09-07 Review fixes: series protection R, I2C1 2.2k, C102 50V, gate & buck soft-start
    7.f - PA2/PA3 = TTa (not 5V tolerant), PD2 = FT (5V tolerant) per STM32F405
    DS8626. Add series R on the STM32 pin side: R205 1k ESC_TLM, R206 1k GPS_TX,
    R207 1k GPS_RX (limits fault injection into PA2/PA3 to ~1.2 mA on a 5V UART).
    3.a - Cross-domain series R: R208 470 BRIDGE_TX, R209 470 BRIDGE_RX, R210 470
    ESP_STM_NRST (R203 pull-down + Q201 gate kept on the local node -> ESP-absent
    fail-safe preserved).
    6.a - I2C1 pull-ups R401/R402 4.7k -> 2.2k (C4190). With J703 cabled
    (~90-100 pF): t_r ~= 186 ns < 300 ns (400 kHz); sink 1.4 mA at VOL.
    1.a - C102 10uF 25V -> 50V (C138687), for 4S input transients + DC-bias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
    [baro_flash.kicad_sch, connectors.kicad_sch, dronekit-pro.kicad_sch, stm32_core.kicad_sch]
2026-09-07 Audit custom symbols; fix MP2307DN pin 1 name + BS/SW/COMP types
    Pin-by-pin audit of MP2307DN and RT9013-33 in dronekit-pro-lib.kicad_sym vs
    their datasheets (dronekit-pro-lib-audit.md).
    - RT9013-33: all 5 pins correct (number, name, type). No change.
    - MP2307DN: pin 1 name BST -> BS (datasheet uses "BS"); BS, SW, COMP
    electrical type output/input -> passive (KiCad-convention cleanup, cap/RC
    nodes - no ERC or functional effect). Pin 8 SS was fixed earlier.
    Symbol re-embedded in the schematic.
    ERC: 0 errors / 0 isolated_pin_label / 2 known pin_to_pin warnings.
    Claude-Session: https://claude.ai/code/session_0171uwNh8K8uwZuWio9f35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
    [dronekit-pro.kicad_sch]
